KanadeSisido/ecapa-tdnn-quantized/(commit log)

2026-11-09 pendant/mobile/demo: アプリ画面の自動録画（Maestro + scrcpy）とエージェント用プロンプト
    - record.sh: クラウド送信をオン・相談履歴を消去 → scrcpy で録画しながら flow を再生 → mp4
    - flows/tour.yaml: ホーム → 要約で相談 → 報告書 → ログ → 診療 → 設定 の全画面ツアー
    - README.md: 準備・注意点・トラブル対処と、AI エージェントにそのまま渡すプロンプト
2026-11-09 pendant/mobile/demo: record.sh の録画が止まらない問題と、スクリーンショットの保存先を直す
    scrcpy はウィンドウを出さずに録画し、TERM で止める（スクリプト内のバックグラウンドのプロセスは SIGINT を無視し、ウィンドウを出すと画面の無い環境で固まるため）。Maestro 2.x が ~/.maestro/tests/ に保存するスクリーンショットを、実行後に out/shots/ に集める。
2026-11-10 pendant/mobile/demo: main の取り込みに合わせて、デモ前の確認と README のリンクを追加
    - record.sh: 録画前にサーバーのトークンと声の相談 API の有無を確認する
    - demo/README.md: デモの前に確認すること（クラウド送信のオン、履歴の消去）
    - pendant/mobile/README.md・ルート README から demo/ にリンク
    - ルート README: server/ は main に入ったので「server ブランチ」の注記を外す
